MasonG611/Shark-Park/(commit log)

2021-10-25 Motor Controller Code
2021-10-29 Corrected Motor Controller Code
    [MotorController.py]
2022-03-11 Motor Controller code addition
2022-03-11 Tidied up RFID_MC.py and fixed some bugs
    [RFID_MC.py]
2022-04-14 Added USART Communication code for Arduino
2022-04-27 Added working Raspberry Pi/Linka code
